Scrys26/Proyecto-Digitales/BattleshipVGA_MMIO/BattleShip.png

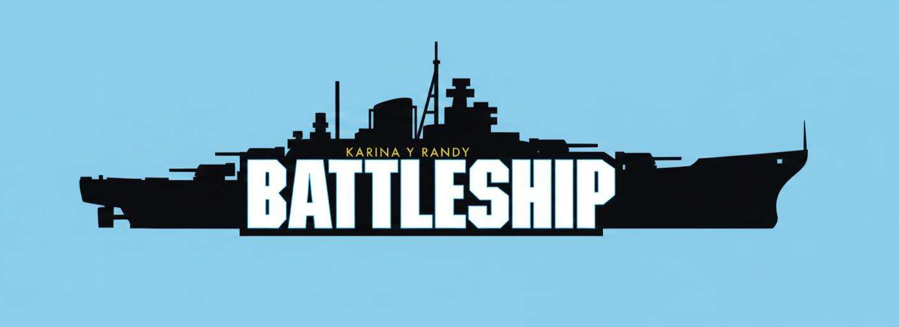
BattleshipVGA_MMIO/BattleShip.png
