Scrys26/Proyecto-Digitales/Figuras/Controlador_VGA.PNG

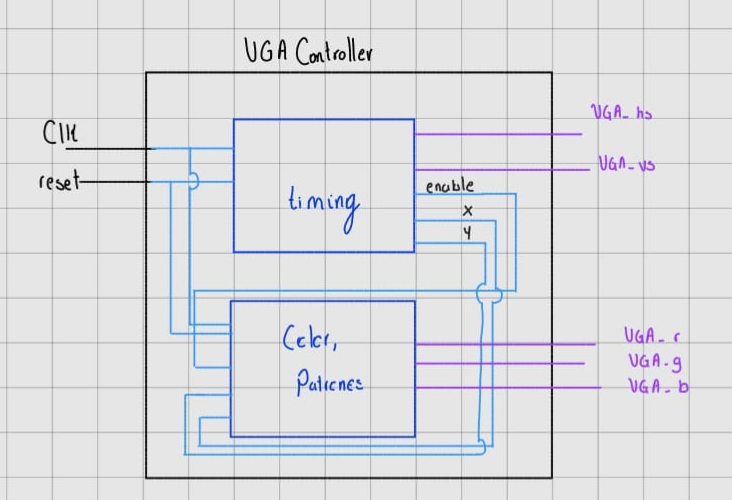
Figuras/Controlador_VGA.PNG
