Scrys26/Proyecto-Digitales/Figuras/Core.png

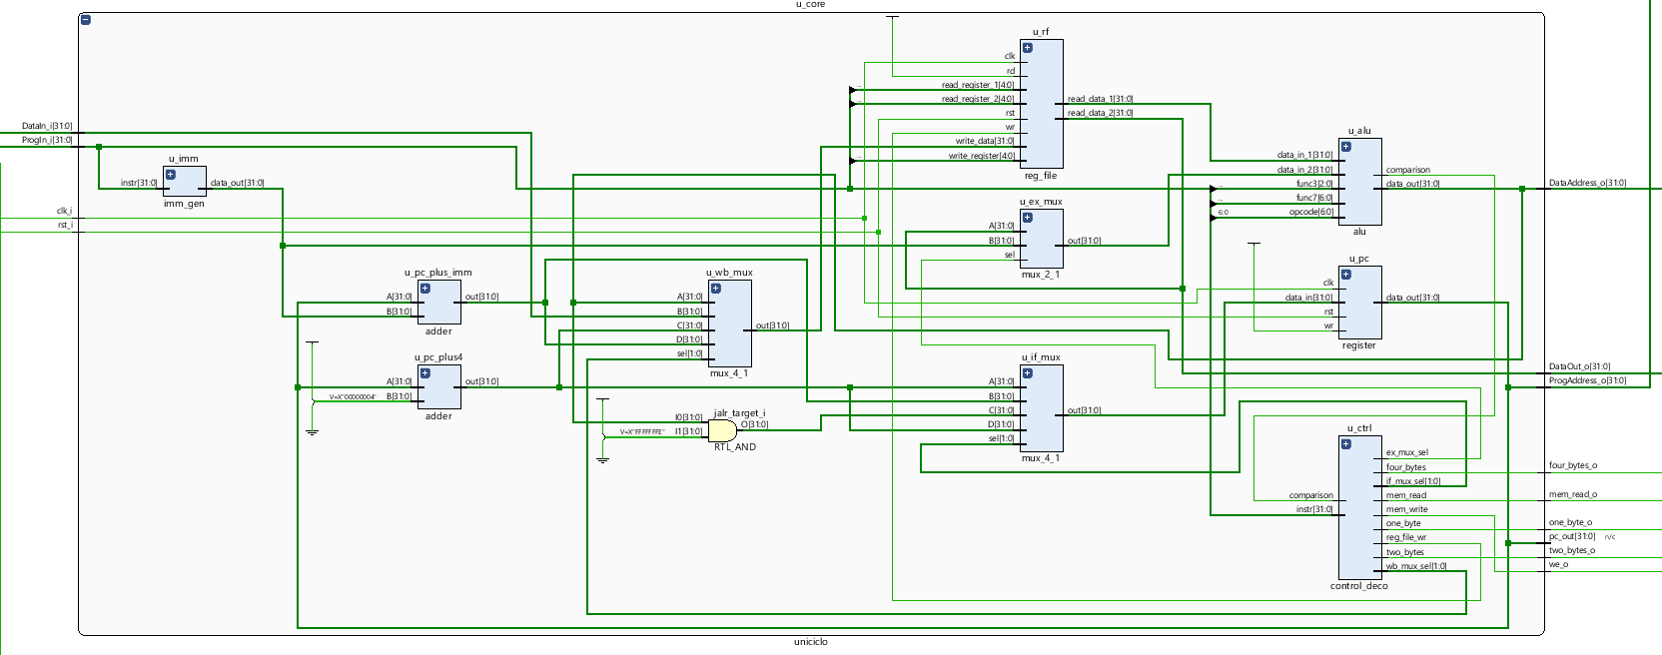
Figuras/Core.png
