Scrys26/Proyecto-Digitales/Figuras/Diagrama de flujo.jpeg

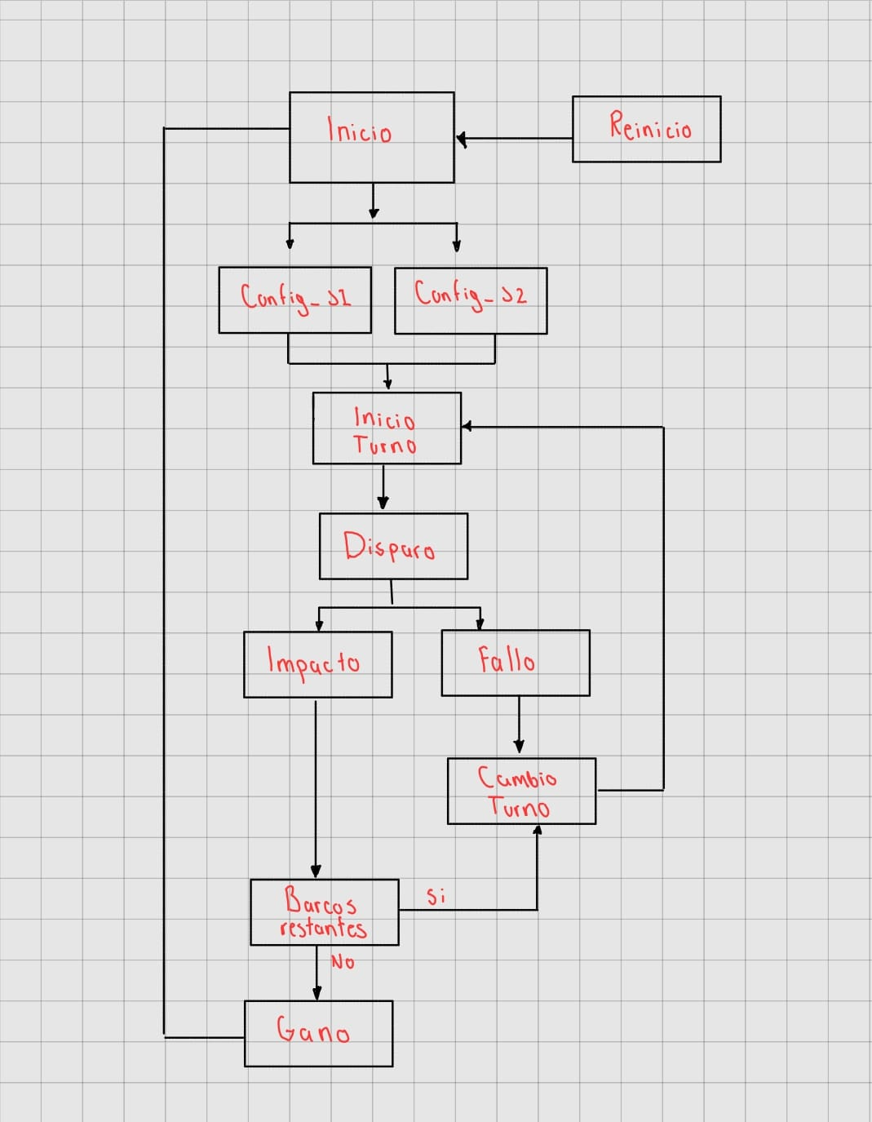
Figuras/Diagrama de flujo.jpeg
