Scrys26/Proyecto-Digitales/Figuras/mando.jpg

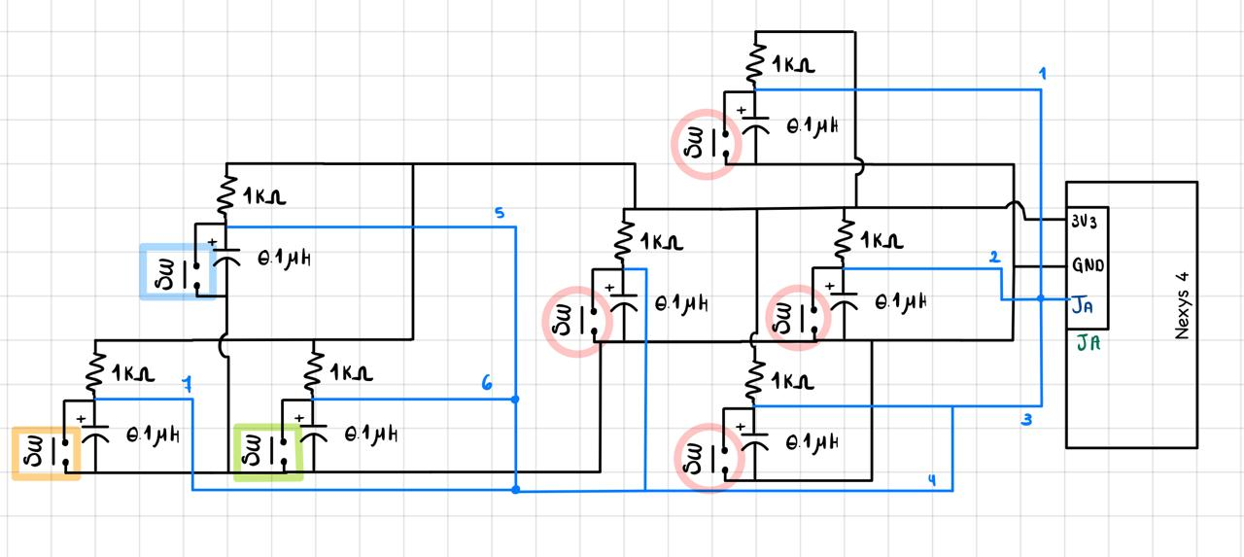
Figuras/mando.jpg
