Scrys26/Proyecto-Digitales/Figuras/Timer.PNG

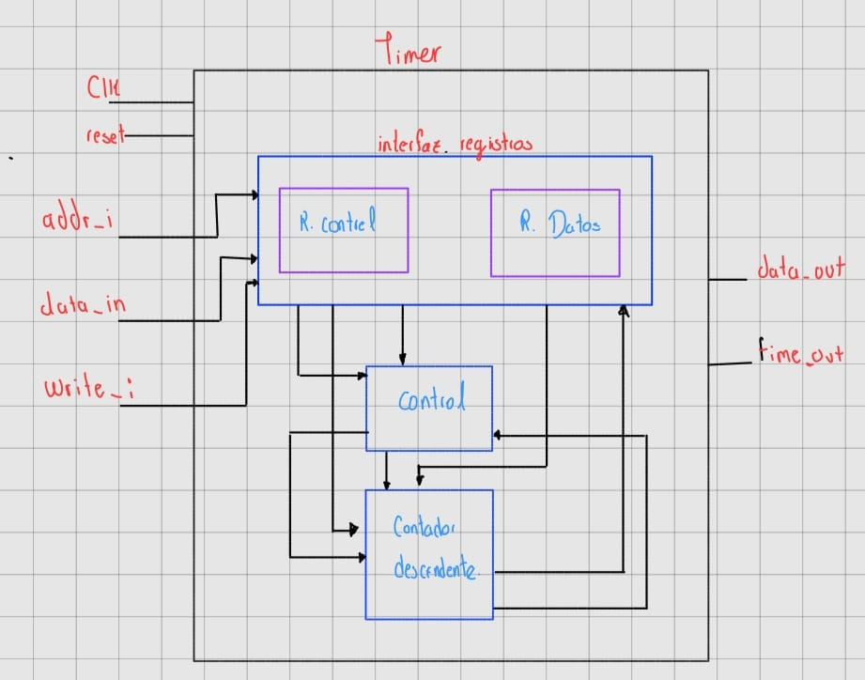
Figuras/Timer.PNG
