Scrys26/Proyecto-Digitales/Figuras/WhatsApp Image 2025-10-30 at 6.08.31 PM.jpeg

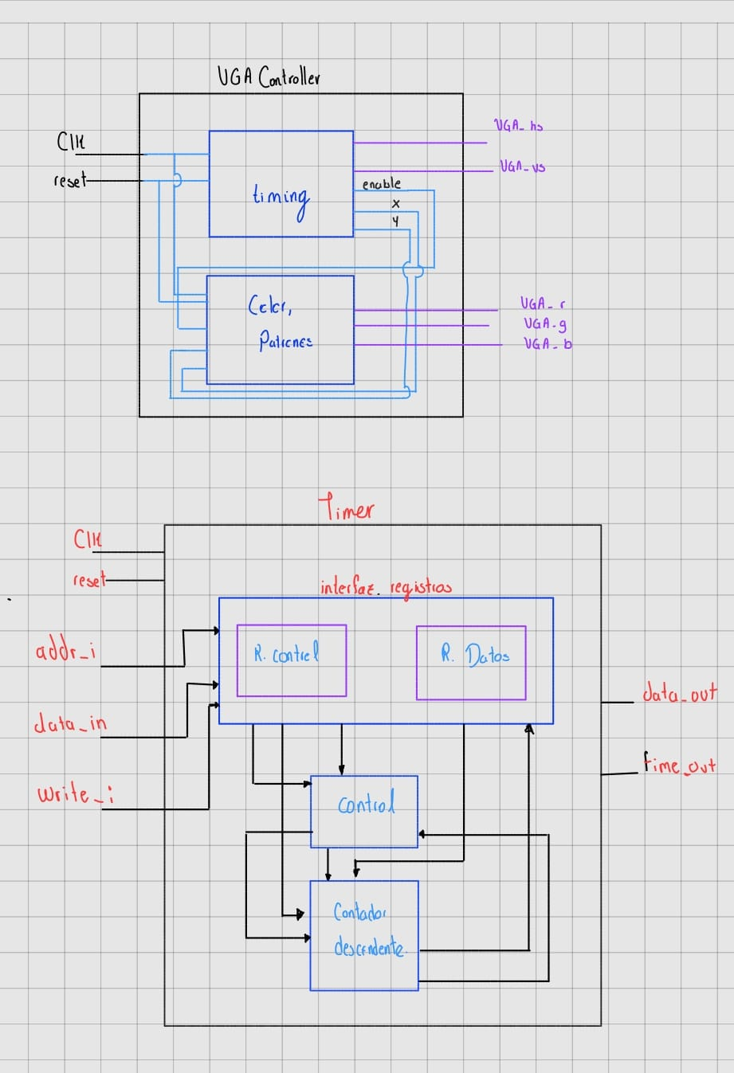
Figuras/WhatsApp Image 2025-10-30 at 6.08.31 PM.jpeg
