Scrys26/Proyecto-Digitales/VGA/Simulacion/frame.png

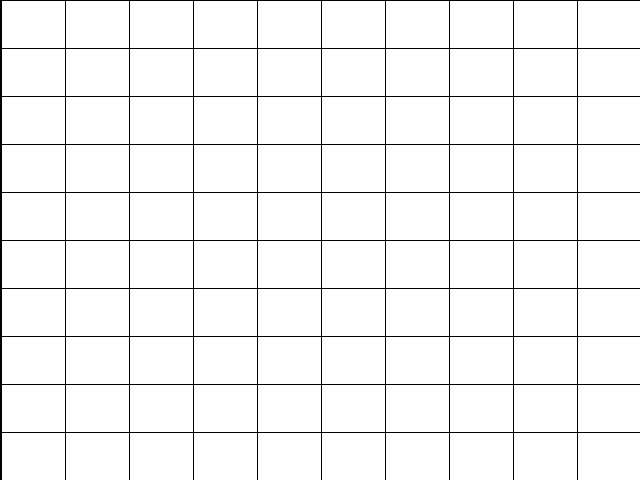
VGA/Simulacion/frame.png
