Scrys26/Proyecto-Digitales/Interfaz UART/UART_tx.vhd

library ieee;
use ieee.std_logic_1164.all;
use ieee.numeric_std.all;



entity uart_tx is

    generic(
        -- BAUD_CLK_TICKS: integer := 1041); -- clk/baud_rate (10 000 000 / 9600 = 1041,67)
        BAUD_CLK_TICKS: integer := 139); -- clk/baud_rate (16 000 000 / 115200 = 138.89)
    port(
        clk            : in  std_logic;
        reset          : in  std_logic;
        tx_start       : in  std_logic;
        tx_rdy         : out std_logic;
        tx_data_in     : in  std_logic_vector (7 downto 0);
        tx_data_out    : out std_logic
        );
end uart_tx;


architecture Behavioral of uart_tx is

    type tx_states_t is (IDLE, START, DATA, STOP);
    signal tx_state  : tx_states_t := IDLE;


    signal baud_rate_clk     : std_logic:= '0';

    signal data_index        : integer range 0 to 7 := 0;
    signal data_index_reset  : std_logic := '1';
    signal stored_data       : std_logic_vector(7 downto 0) := (others=>'0');

    signal start_detected    : std_logic := '0';
    signal start_reset       : std_logic := '0';
    
    signal tx_end             : std_logic := '0';
    signal edge_signal        : std_logic := '0';

begin


-- The baud_rate_clk_generator process generates the UART baud rate clock by
-- setting the baud_rate_clk signal when the counter counts BAUD_CLK_TICKS
-- ticks of the master clk. The BAUD_CLK_TICKS constant is specified in
-- the package and reflects the ratio between the master clk and the baud rate.

    baud_rate_clk_generator: process(clk)
    variable baud_count: integer range 0 to (BAUD_CLK_TICKS - 1) := (BAUD_CLK_TICKS - 1);
    begin
        if rising_edge(clk) then
            if (reset = '1') then
                baud_rate_clk <= '0';
                baud_count := (BAUD_CLK_TICKS - 1);
            else
                if (baud_count = 0) then
                    baud_rate_clk <= '1';
                    baud_count := (BAUD_CLK_TICKS - 1);
                else
                    baud_rate_clk <= '0';
                    baud_count := baud_count - 1;
                end if;
            end if;
        end if;
    end process baud_rate_clk_generator;


-- The tx_start_detector process works on the master clk frequency and catches
-- short (one clk cycle long) impulses in the tx_start signal and keeps it for
-- the uart_tx_FSM. tx_start_detector is needed because the uart_tx_FSM works on
-- the baud rate frequency, but the button_debounce module generates one master clk
-- cycle long impulse per one button push. start_detected keeps the information that
-- such event has occurred.
-- The second purpose of tx_start_detector is to secure the transmitting data.
-- stored_data keeps the transmitting data saved during the transmission.

    tx_start_detector: process(clk)
    begin
        if rising_edge(clk) then
            if (reset ='1') or (start_reset = '1') then
                start_detected <= '0';
            else
                if (tx_start = '1') and (start_detected = '0') then
                    start_detected <= '1';
                    stored_data <= tx_data_in;
                end if;
            end if;
        end if;
    end process tx_start_detector;


-- The data_index_counter process is a simple counter from 0 to 7 working on the baud
-- rate frequency. It is used to perform transformation between the parallel
-- data (stored_data) and the serial output (tx_data_out).
-- The data_index signal is used in uart_tx_FSM to go over the stored_data vector
-- and send the bits one by one.

    data_index_counter: process(clk)
    begin
        if rising_edge(clk) then
            if (reset = '1') or (data_index_reset = '1') then
                data_index <= 0;
            elsif (baud_rate_clk = '1') then
                data_index <= data_index + 1;
            end if;
        end if;
    end process data_index_counter;


-- The UART_FSM_tx process represents a Finite State Machine which has
-- four states (IDLE, START, DATA, STOP). See inline comments for more details.

    uart_tx_FSM: process(clk)
    begin
        if rising_edge(clk) then
            if (reset = '1') then
                tx_state <= IDLE;
                data_index_reset <= '1';   -- keep data_index_counter on hold
                start_reset <= '1';        -- keep tx_start_detector on hold
                tx_data_out <= '1';        -- keep tx line set along the standard
                tx_end      <= '0';
            else
                if (baud_rate_clk = '1') then   -- the FSM works on the baud rate frequency
                    case tx_state is

                        when IDLE =>
                            tx_end           <= '0';
                            data_index_reset <= '1';    -- keep data_index_counter on hold
                            start_reset <= '0';         -- enable tx_start_detector to wait for starting impulses
                            tx_data_out <= '1';         -- keep tx line set along the standard

                            if (start_detected = '1') then
                                tx_state <= START;
                            end if;

                        when START =>
                            tx_end           <= '0';
                            data_index_reset <= '0';   -- enable data_index_counter for DATA state
                            tx_data_out <= '0';        -- send '0' as a start bit

                            tx_state <= DATA;

                        when DATA =>

                            tx_data_out <= stored_data(data_index);   -- send one bit per one baud clock cycle 8 times

                            if (data_index = 7) then
                                data_index_reset <= '1';              -- disable data_index_counter when it has reached 8
                                tx_state <= STOP;
                            end if;

                        when STOP =>

                            tx_data_out <= '1';     -- send '1' as a stop bit
                            start_reset <= '1';     -- prepare tx_start_detector to be ready detecting the next impuls in IDLE
                            tx_end      <= '1';
                            tx_state <= IDLE;

                        when others =>
                            tx_end      <= '0';
                            tx_state    <= IDLE;
                    end case;
                end if;
            end if;
        end if;
    end process uart_tx_FSM;

    TX_RDY_P : process(clk)
    begin
        if rising_edge(clk) then
            if (reset = '1') then
                tx_rdy      <= '0'; 
                edge_signal <= '0';
            else
                tx_rdy      <= tx_end and (not edge_signal);
                edge_signal <= tx_end ;
            end if;
         end if;
      end process TX_RDY_P;
      
end Behavioral;
