Scrys26/Proyecto-Digitales/Interfaz UART/UART.vhd

library IEEE;
use IEEE.STD_LOGIC_1164.ALL;


use IEEE.NUMERIC_STD.ALL;



entity UART is

    port(
        clk            : in  std_logic;
        reset          : in  std_logic;
        tx_start       : in  std_logic;
        
        tx_rdy         : out std_logic;
        rx_data_rdy    : out std_logic;

        data_in        : in  std_logic_vector (7 downto 0);
        data_out       : out std_logic_vector (7 downto 0);

        rx             : in  std_logic;
        tx             : out std_logic
        );
end UART;


architecture Behavioral of UART is

    component uart_tx
        port(
            clk            : in  std_logic;
            reset          : in  std_logic;
            tx_start       : in  std_logic;
            tx_rdy         : out std_logic;
            tx_data_in     : in  std_logic_vector (7 downto 0);
            tx_data_out    : out std_logic
            );
    end component;


    component uart_rx
        port(
            clk            : in  std_logic;
            reset          : in  std_logic;
            rx_data_in     : in  std_logic;
            rx_data_rdy    : out std_logic;
            rx_data_out    : out std_logic_vector (7 downto 0)
            );
    end component;

begin

    transmitter: uart_tx
    port map(
            clk            => clk,
            reset          => reset,
            tx_start       => tx_start,
            tx_rdy         => tx_rdy,
            tx_data_in     => data_in,
            tx_data_out    => tx
            );


    receiver: uart_rx
    port map(
            clk            => clk,
            reset          => reset,
            rx_data_in     => rx,
            rx_data_rdy    => rx_data_rdy,
            rx_data_out    => data_out
            );


end Behavioral;
